rpocc/PALDump/Breadboard_Proto.jpg

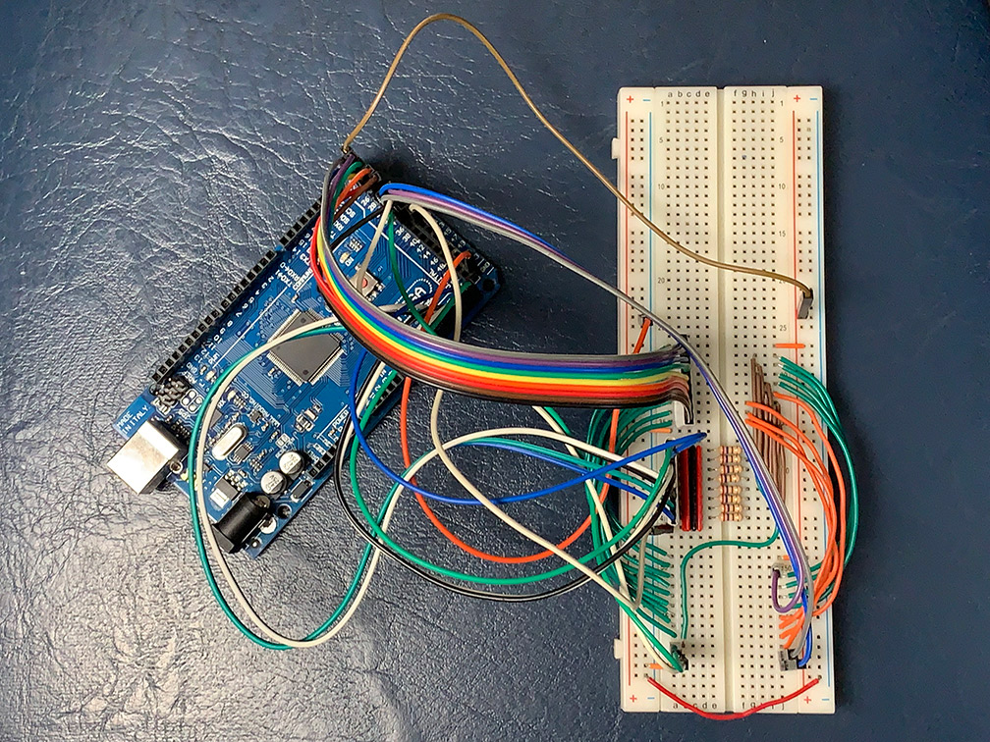
Breadboard_Proto.jpg
