rpocc/PALDump/PALDumper Wiring.pdf

### MADE IN ITALY

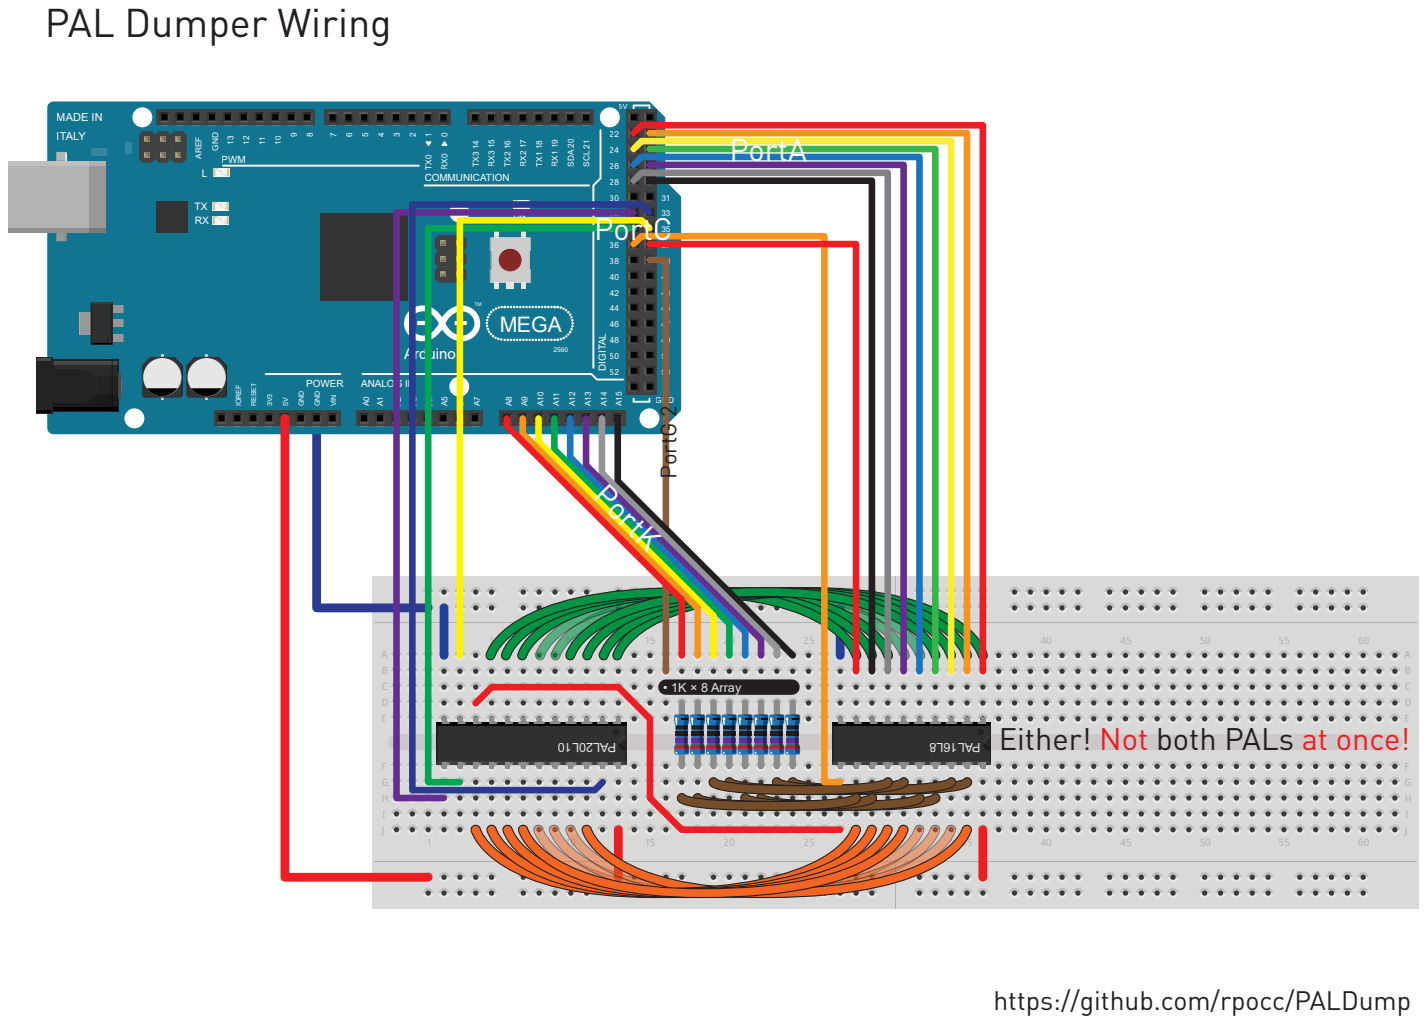
[picture p3: page 1]
• 1K × 8 Array; ANALOG IN; COMMUNICATION; POWER; AREF; GND; RESET; VIN; SDA 20; SCL 21; PWM; DIGITAL; MEGA; IOREF; Arduino; PortG 2; PortA; PortC; PortK

PAL Dumper Wiring

Either! Not both PALs at once!

https://github.com/rpocc/PALDump
