rpocc/PALDump/PAL database/IO HFA-110W/TEST_REPORT.txt

Original: FDD works OK
No chip: DOesn't load
Replacement: FDD works OK
MFM wasn't tested
