rpocc/PALDump/(commit log)

2024-02-25 Arduino code version 1.0
2024-02-26 Version 1.1
    Fixed:
    * Problems caused by AVG-Gcc bit shift bugs
    * Bug with extra input terms in the berkeley format
    Added:
    More informative input/output list
    TBD:
    More tests with PAL20
    [PALDump.cpp, PALDump.h, PALDump_2560.ino]
2024-03-01 Version 1.3. PAL16L8 support confirmed.
    PAL16 seems to work fine
    PAL20: produces doubtful results.
    Only available PAL20 IC I have are either ATF20V8B in registered mode, installed on a board with unknown function and PAL20L8ACSA with feedbacks, installed on Paradise boards. After minimization it gives exceeding (>7) number of terms at some outputs, which are confirmed to use feedbacks from other outputs.
2024-03-15 Hyundai Super-16V added
    An XT-compatible motherboard using PAL for redirecting COM/LPT/FDD ports to controllers, and enabling /OE on EPROM.
2024-03-16 OTIVGA dumps uploaded
    VGA cards based on Oak Technology OTI037C chipset:
    OTIVGA 1037162003 REV. A
    Hedaka HED-622 (Schematic and PALs are identical to OTIVGA Rev. D)
    OTIVGA 1037164002 REV. D
2024-12-24 Wiring diagram added
